haunma/wwu_pico/hardware/weights.ods

Quantity | Part | Package | Unit mass, mg | Total mass, mg | (Source)
1 | STM32L031F | TSSOP-20 | 75 | 75 | TI document
1 | LPS225HB | HLGA-8 | 25 | 25 | TI document (extrapolated)
1 | Si5351A | MSOP-10 | 40 | 40 | TI document (extrapolated)
1 | TPS7A03xx | SOT23-5 | 12 | 12 | Zetex (http://www.elsoc.net/uploads/7/0/6/3/70631651/sot23-5.pdf)
4 | MPT2.4-21 | n/a | 400 | 1600 | Powerfilm
1 | SCCT30B186SRB | n/a | 4700 | 4700 | measurement
1 | SiT1566 | odd CSP | 5 | 5 | wild guess
2 | BSS816NWH | SC70 | 5 | 10 | wild guess
1 | ECS-250-10-37B2-CWN | 2x1.6 crystal | 10 | 10 | guess (1.44 mm^3)
2 | CUS10S30 | custom diode | 4.5 | 9 | datasheet
6 | 0603 resistors | 0603 | 2 | 12 | Yageo datasheet
14 | 0603 caps and other | 0603 | 6 | 84 | guess
1.5 | PCB, 1-oz cu, 2 layer, per in^2 |  | 1127 | 1690.5 | assumes 0.6 mm thickness with 100% copper (solder will compensate for etched copper); the FR4 is still ~ 2/3 of the weight
25.8 | 30-ga mag wire, per foot |  | 140 | 3612 | using 468/f for half-wave dipole length
 |  |  | Total weight: | 11.8845 | g
