haunma/wwu_pico/hardware/wwu_pico1.pdf

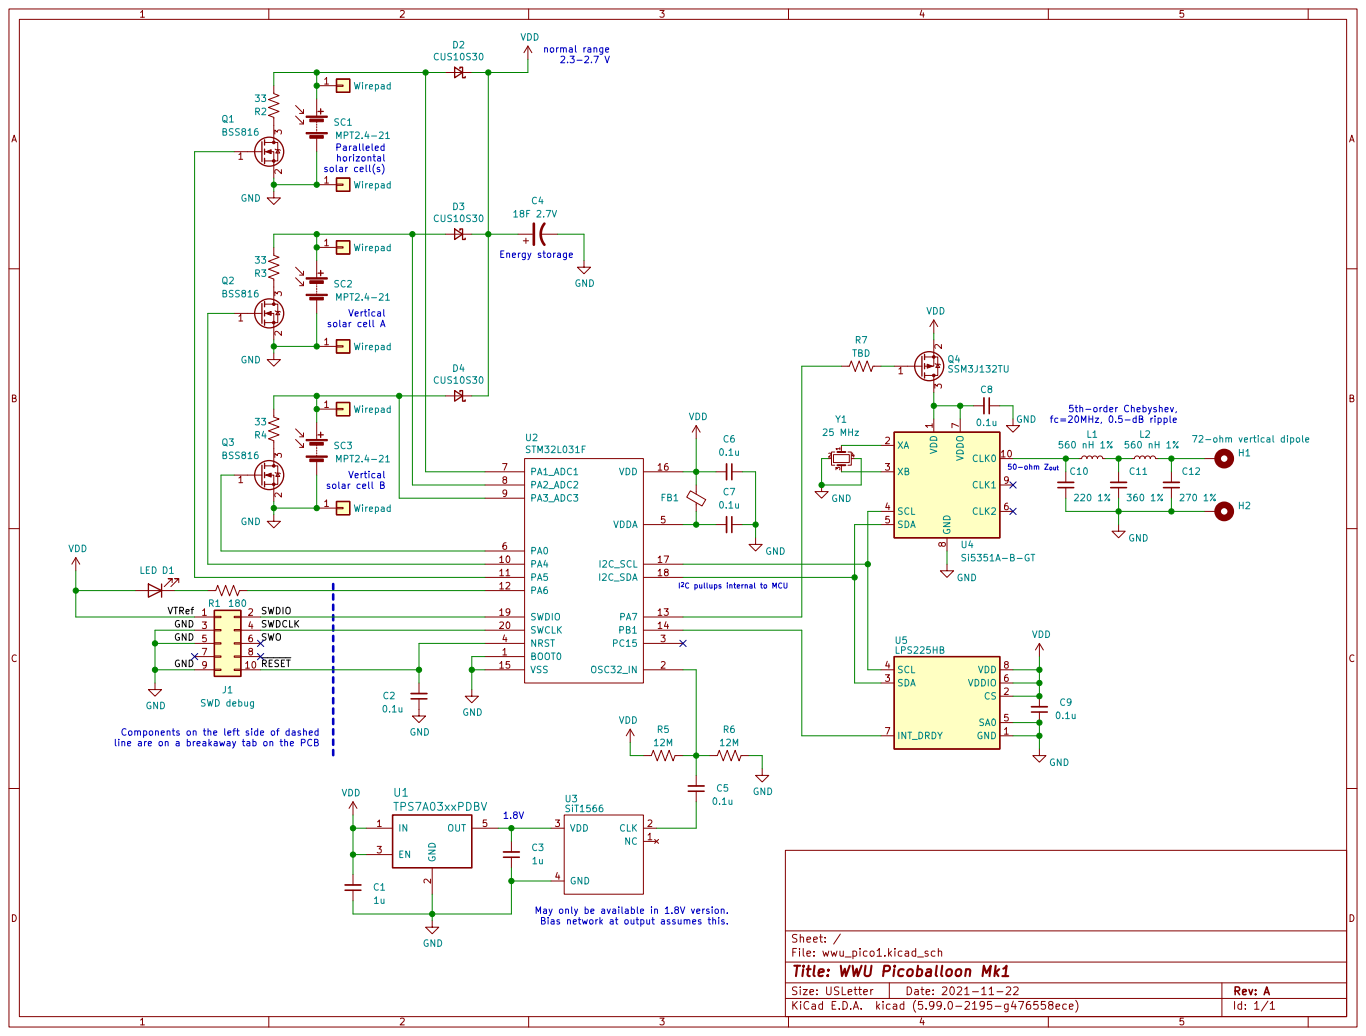
[picture p1: page 1]

1 CLK0 10 XA 2 XB 3 SCL 4 SDA 5 CLK2 6 VDDO

I^{2}C pullups internal to MCU Vertical solar cell B

GND GND GND 5 | 6 SWO

1.8V Components on the left side of dashed
line are on a breakaway tab on the PCB

May only be available in 1.8V version.
Bias network at output assumes this.

File: wwu_pico1.kicad_sch Sheet: /
Id: 1/1 Title: WWU Picoballoon Mk1
