haunma/wwu_pico/hardware/wwu_pico1.kicad_pcb

## KiCad design hardware/wwu_pico1.kicad_pcb (2022-04-17)

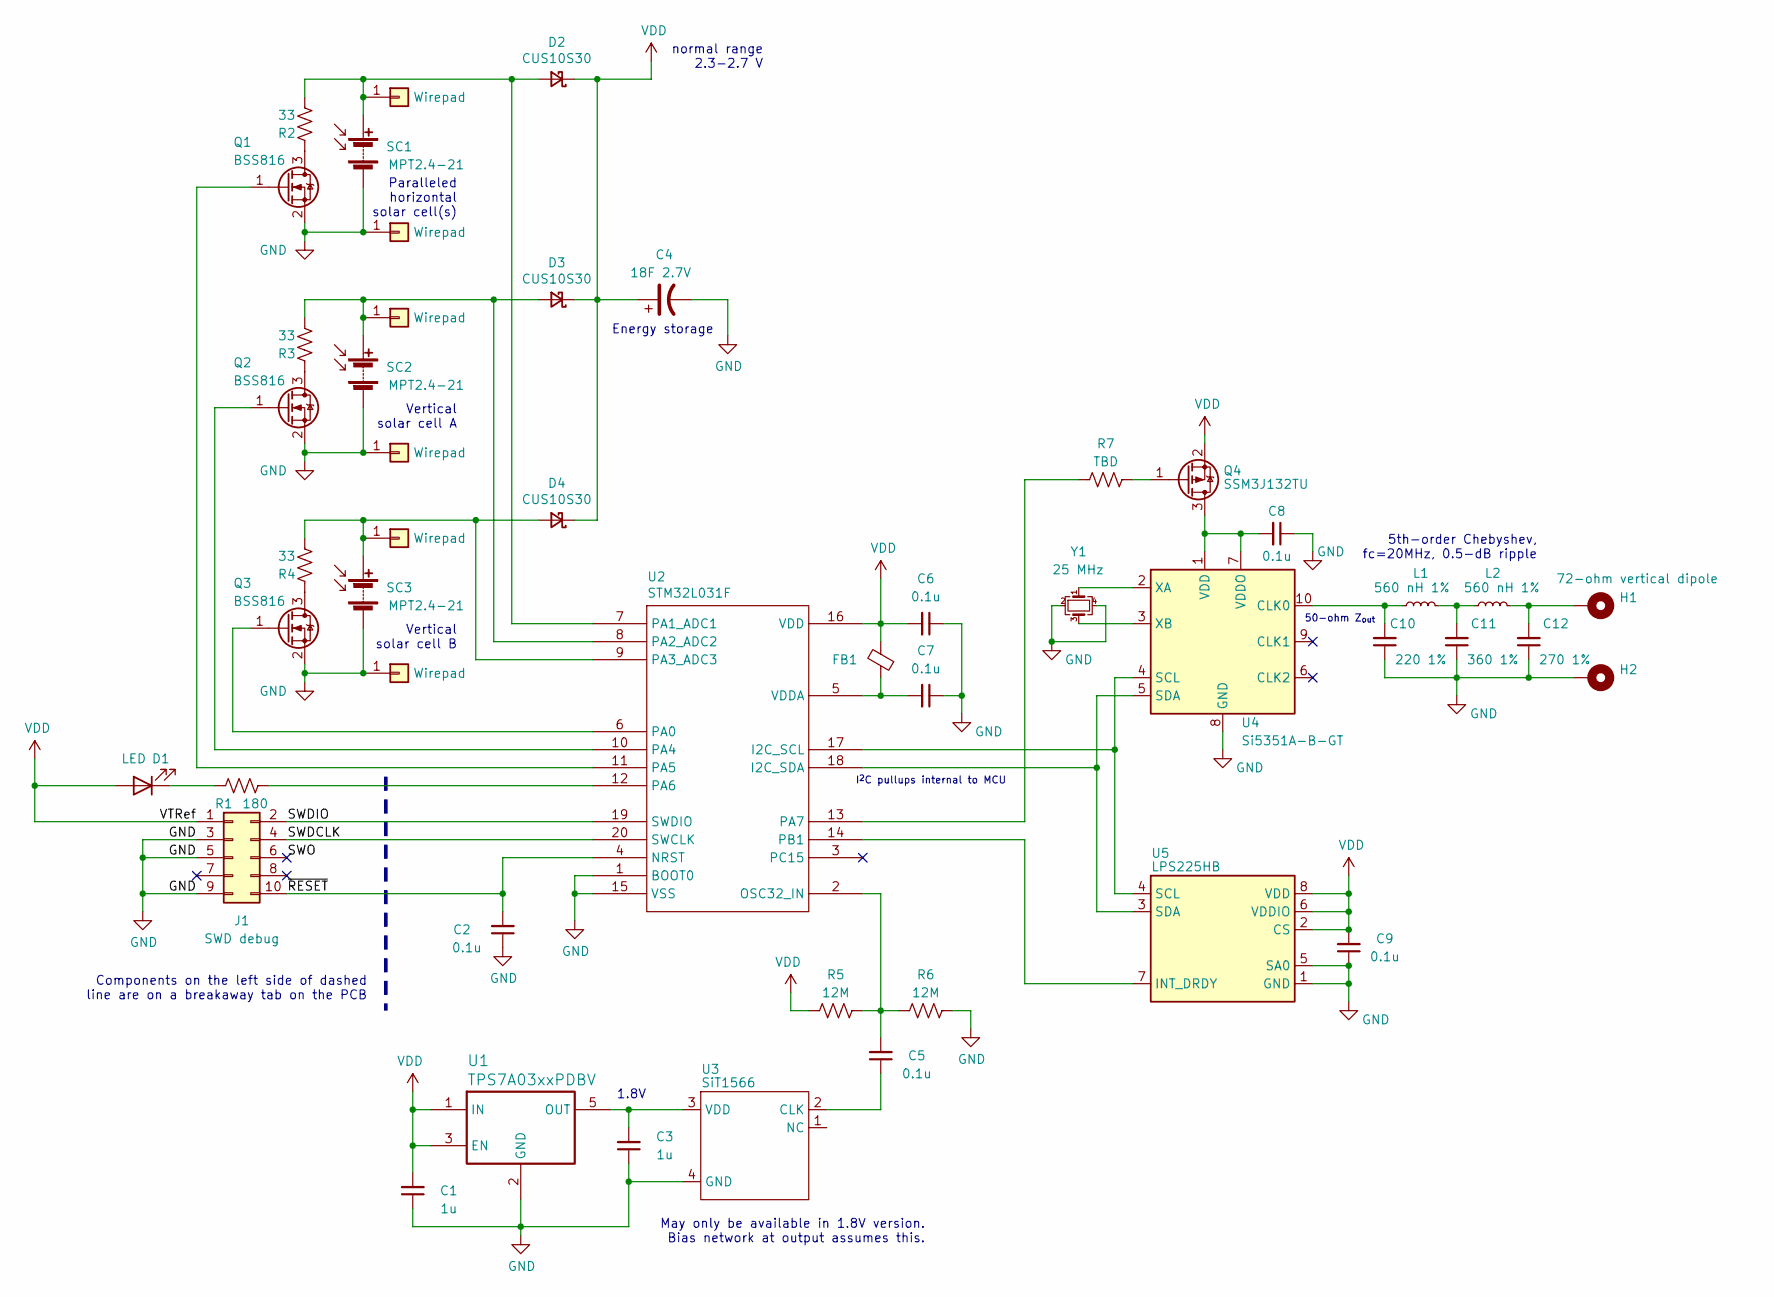
[picture p2: schematic wwu_pico1.kicad_sch, WWU Picoballoon Mk1]

Parts:
C1, C3: 1u; C_0603
C2, C5, C6, C7, C8, C9: 0.1u; C_0603
C4: 18F 2.7V; CP_Radial_D12.5mm_P5.00mm
C10: 220 1%; C_0603
C11: 360 1%; C_0603
C12: 270 1%; C_0603
D1: LED; LED_0603
D2, D3, D4: CUS10S30; D_SOD-323_HandSoldering
FB1: Ferrite_Bead_Small; R_0603
H1, H2: 72-ohm vertical dipole; SolderWirePad_single_0-8mmDrill
J1: SWD debug; Pin_Header_Straight_2x05_Pitch1.27mm
J2, J3, J4, J5, J6, J7: Wirepad; SolderWirePad_single_0-8mmDrill
L1, L2: 560 nH 1%; L_Abracon_ASPI-3012S
Q1, Q2, Q3: BSS816; SOT-323_SC-70
Q4: SSM3J132TU; SOT-323_SC-70
R1: 180; R_0603
R2, R3, R4: 33; R_0603
R5, R6: 12M; R_0603
R7: TBD; R_0603
SC1, SC2, SC3: MPT2.4-21
U1: TPS7A03xxPDBV; SOT-23-5
U2: STM32L031F; TSSOP-20_4.4x6.5mm_Pitch0.65mm
U3: SiT1566; SiTime_SiT1566
U4: Si5351A-B-GT; MSOP-10_3x3mm_Pitch0.5mm
U5: LPS225HB; ST_HLGA_8L
Y1: 25 MHz; Crystal_SMD_2016-4pin_2.0x1.6mm

Connections:
/SWDCLK: J1.4, U2.20 (SWCLK)
/SWDIO: J1.2, U2.19 (SWDIO)
/SWO: J1.6
/~RESET: C2.2, J1.10, U2.4 (NRST)
GND: C1.1, C2.1, C3.1, C4.2, C6.1, C7.1, C8.1, C9.1, C10.1, C11.1, C12.1, H2.1, J1.3, J1.5, J1.9, J3.1, J5.1, J7.1, Q1.2 (S), Q2.2 (S), Q3.2 (S), R6.1, SC1.2 (-), SC2.2 (-), SC3.2 (-), U1.2 (GND), U2.1 (BOOT0), U2.15 (VSS), U3.4 (GND), U4.8 (GND), U5.1 (GND), U5.5 (SA0), Y1.2, Y1.4
unnamed: C3.2, U1.5 (OUT), U3.3 (VDD)
unnamed: C5.1, U3.2 (CLK)
unnamed: C5.2, R5.1, R6.2, U2.2 (OSC32_IN)
unnamed: C7.2, FB1.1, U2.5 (VDDA)
unnamed: C8.2, Q4.3 (D), U4.1 (VDD), U4.7 (VDDO)
unnamed: C10.2, L1.1, U4.10 (CLK0)
unnamed: C11.2, L1.2, L2.1
unnamed: C12.2, H1.1, L2.2
unnamed: D1.1 (K), R1.1
unnamed: D2.2 (A), J2.1, R2.2, SC1.1 (+), U2.7 (PA1_ADC1)
unnamed: D3.2 (A), J4.1, R3.2, SC2.1 (+), U2.8 (PA2_ADC2)
unnamed: D4.2 (A), J6.1, R4.2, SC3.1 (+), U2.9 (PA3_ADC3)
unnamed: Q1.1 (G), U2.11 (PA5)
unnamed: Q1.3 (D), R2.1
unnamed: Q2.1 (G), U2.10 (PA4)
unnamed: Q2.3 (D), R3.1
unnamed: Q3.1 (G), U2.6 (PA0)
unnamed: Q3.3 (D), R4.1
unnamed: Q4.1 (G), R7.1
unnamed: R1.2, U2.12 (PA6)
unnamed: R7.2, U2.13 (PA7)
unnamed: U2.14 (PB1), U5.7 (INT_DRDY)
unnamed: U2.17 (I2C_SCL), U4.4 (SCL), U5.4 (SCL)
unnamed: U2.18 (I2C_SDA), U4.5 (SDA), U5.3 (SDA)
unnamed: U4.2 (XA), Y1.1
unnamed: U4.3 (XB), Y1.3
VDD: C1.2, C4.1, C6.2, C9.2, D1.2 (A), D2.1 (K), D3.1 (K), D4.1 (K), FB1.2, J1.1, Q4.2 (S), R5.2, U1.1 (IN), U1.3 (EN), U2.16 (VDD), U5.2 (CS), U5.6 (VDDIO), U5.8 (VDD)

Notes on the sheet:
Components on the left side of dashed line are on a breakaway tab on the PCB
Paralleled horizontal solar cell(s)
Vertical solar cell A
Vertical solar cell B
1.8V
Energy storage
normal range 2.3-2.7 V
May only be available in 1.8V version. Bias network at output assumes this.
I^{2}C pullups internal to MCU
50-ohm Z_{out}
5th-order Chebyshev, fc=20MHz, 0.5-dB ripple

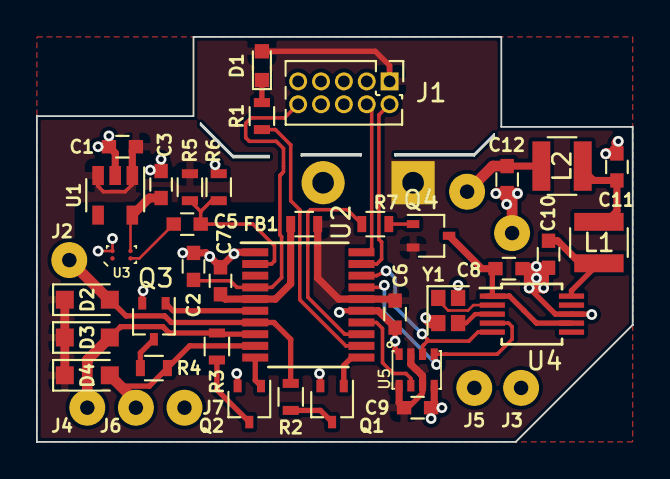
[picture p3: board wwu_pico1.kicad_pcb from above]

Board: 2 copper layers, 33.1 x 22.5 mm, 45 parts (1 on the bottom side), 31 nets.
